slastra/actuator/hardware/servo-bracket.stl

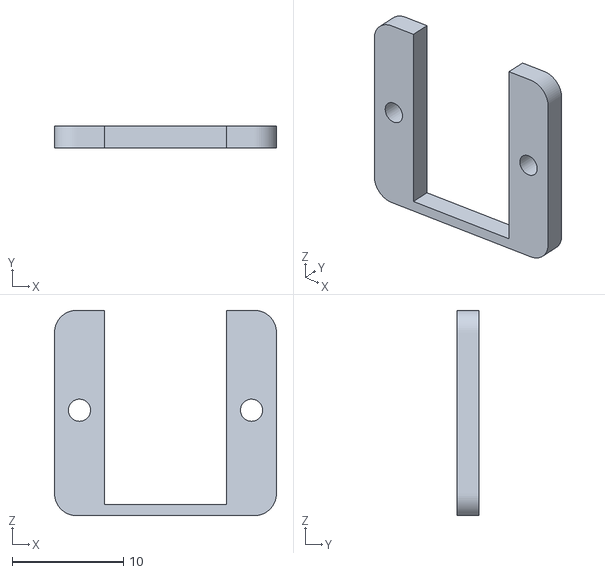
[picture p11: CAD file, 2026-11-09]
hardware/servo-bracket.stl
20.0 x 2.00 x 18.5
