slastra/actuator/hardware/door.stl

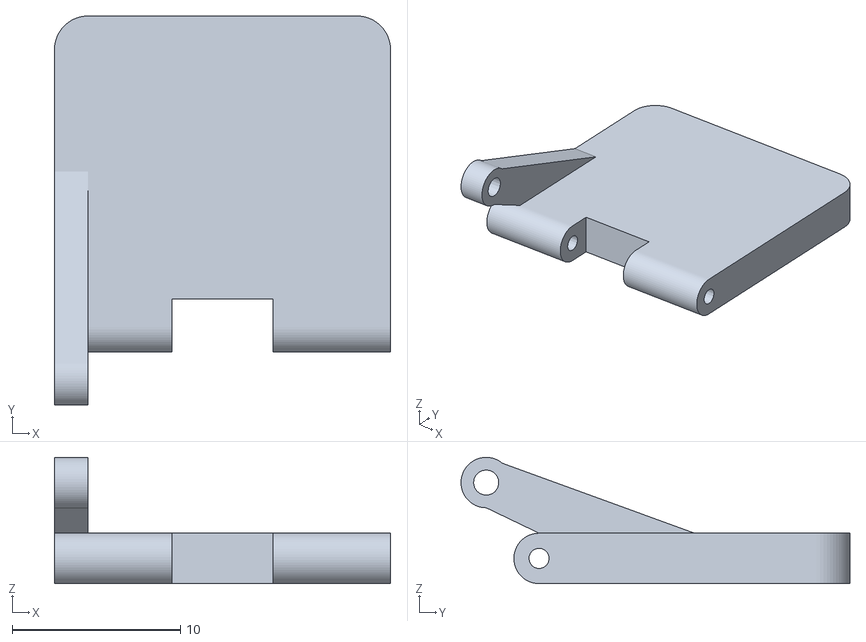
[picture p12: CAD file, 2026-11-09]
hardware/door.stl
20.0 x 23.1 x 7.51
