slastra/actuator/hardware/body.stl

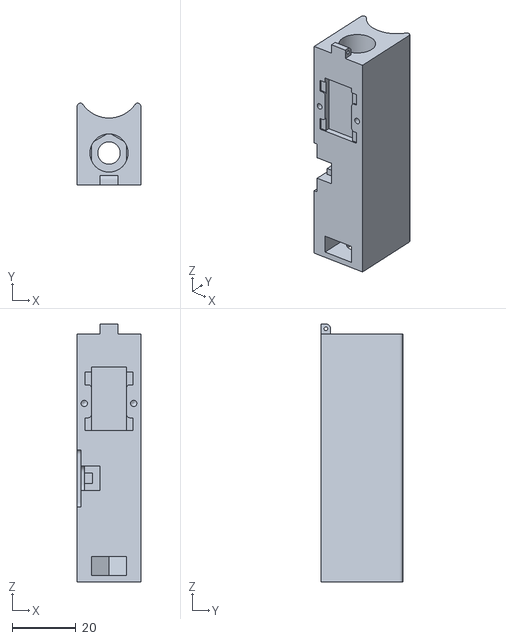
[picture p13: CAD file, 2026-11-09]
hardware/body.stl
20.0 x 25.7 x 81.0
