slastra/actuator/hardware/esp32-bracket.stl

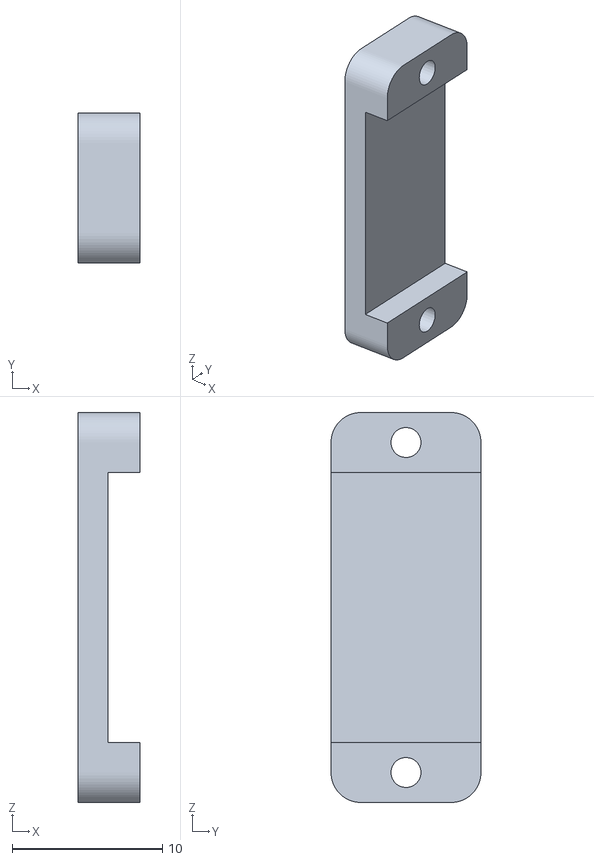
[picture p14: CAD file, 2026-11-09]
hardware/esp32-bracket.stl
4.15 x 10.0 x 26.0
