slastra/actuator/(commit log)

2026-11-09 BLE linear actuator: ESP32-C6 firmware and Android app
    A 1.5 g linear micro servo on a XIAO ESP32C6, swinging a 6 mm horn arm
    through 90 deg, controlled from an Android phone over BLE.
    firmware/ (ESP-IDF 6.0):
    - LEDC PWM at 50 Hz with a linkage-corrected angle mapping
    - Stall protection: clamp to the rated stroke, move-aware release, heat
    budget with lockout
    - NimBLE peripheral with PIN pairing and bonding; protocol in main/ble.h
    - OTA over BLE into A/B slots with project check, verification and
    confirm-or-rollback
    - Status LED; USB console; tools/ota-push, servo.py, servo_gui.py
    android/ (Kotlin, Compose, Material 3 Expressive):
    - Scan by service UUID, pair once, then a horn gauge, an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
    [partitions.csv]
2026-11-09 Add printable parts: body, flap, servo and ESP32 brackets
    [body.stl, esp32-bracket.stl, flap.stl, servo-bracket.stl]
2026-11-09 Render the printed parts: assembly, exploded view and each part
2026-11-09 Center the renders with a margin and keep the shadow on the canvas
    The ortho camera's scale spans the longer side by default, so the portrait
    renders were framed about 8% short and clipped at the bottom. Fit it to the
    width explicitly, frame on the projected vertices instead of the 3D bounding
    box so the silhouette is centred, use a 1.3 margin everywhere, and fade alpha
    over the outer 6% so the shadow-catcher shadow dies out before the edge.
    The overview now uses the padded assembly render instead of a tight trim.
